akpc806a/Incubator-controller/Firmware/STM32F0308-Discovery/Projects/Demonstration/Binary/readme.txt

/**
  @page Demo_Binary   Description of the STM32F0308-Discovery Demonstration firmware's binary files
  
  @verbatim
  ******************** (C) COPYRIGHT 2013 STMicroelectronics *******************
  * @file    readme.txt 
  * @author  MCD Application Team
  * @version V1.0.0
  * @date    02-October-2013
  * @brief   Description of the STM32F0308-Discovery Demonstration firmware's binary files.
  ******************************************************************************
  *
  * Licensed under MCD-ST Liberty SW License Agreement V2, (the "License");
  * You may not use this file except in compliance with the License.
  * You may obtain a copy of the License at:
  *
  *        http://www.st.com/software_license_agreement_liberty_v2
  *
  * Unless required by applicable law or agreed to in writing, software 
  * distributed under the License is distributed on an "AS IS" BASIS, 
  * WITHOUT WARRANTIES OR CONDITIONS OF ANY KIND, either express or implied.
  * See the License for the specific language governing permissions and
  * limitations under the License.
  *
  ******************************************************************************
   @endverbatim

@par Description

This directory contains binary files (*.hex) of the STM32F0308-Discovery 
Demonstration firmware. 
You can use the STM32F0xx’s embedded Bootloader or any in-system programming tool
to reprogram the demonstration using these binary files, as described below:

 + Using "in-system programming tool"
    - Connect the STM32F0308-Discovery board to a PC with a 'USB type A to Mini-B'
      cable through USB connector CN1 to power the board.
    - Make sure that the embedded ST-LINK/V2 is configured for in-system programming
      (both CN3 jumpers ON)
    - Use "STM32F0308-Discovery_Demonstration_V1.0.0.hex" binary with your preferred 
      in-system programming tool to reprogram the demonstration firmware 
      (ex. STM32 ST-LINK Utility, available for download from www.st.com).
          
 * <h3><center>&copy; COPYRIGHT STMicroelectronics</center></h3>
 */
