akpc806a/Incubator-controller/Hardware/IncubatorControl_BOM.xlsx

Qty | Value | Device | Package | Parts | Description | DigiKey partnum / URL | Price, $ | Extended price
4 | Tactile Switch [6 mm outline] | 10-XX | B3F-10XX | S1, S2, S3, S4 |  | 450-1650-ND | 0.11 | 0.44
1 | 0.01 uF | C-EUC0805 | C0805 | C12 | CAPACITOR, European symbol | 399-1158-2-ND |  | 0
2 | 0.1 uF | C-EUC0805 | C0805 | C3, C11 | CAPACITOR, European symbol | 399-1168-2-ND |  | 0
2 | 1 k | R-EU_R0805 | R0805 | R1, R2 | RESISTOR, European symbol | 311-1.0KARTR-ND |  | 0
5 | 1 uF x 25V | C-EUC0805 | C0805 | C4, C5, C6, C7, C10 | CAPACITOR, European symbol | 311-1358-2-ND |  | 0
2 | 10 uF x 25V | CPOL-EUTT2D4L | TT2D4L | C8, C9 | POLARIZED CAPACITOR, European symbol | P1176-ND | 0.015 | 0.03
1 | 100 | R-EU_R0805 | R0805 | R4 | RESISTOR, European symbol | P100ATR-ND |  | 0
2 | 27 p | C-EUC0805 | C0805 | C1, C2 | CAPACITOR, European symbol | 709-1173-2-ND |  | 0
1 | 3 k | R-EU_R0805 | R0805 | R3 | RESISTOR, European symbol | RMCF0805JT3K00TR-ND |  | 0
2 | 3.3 k | R-EU_R0805 | R0805 | R10, R11 | RESISTOR, European symbol | 1276-5541-2-ND |  | 0
2 | 4.7 k | R-EU_R0805 | R0805 | R8, R9 | RESISTOR, European symbol | P4.7KATR-ND |  | 0
1 | 47 | R-EU_R0805 | R0805 | R5 | RESISTOR, European symbol | RMCF0805JT47R0TR-ND |  | 0
1 | 7805DT | 7805DT | TO252 | IC3 | Positive VOLTAGE REGULATOR | KA7805ERTMFSCT-ND | 0.319 | 0.319
1 | 8 MHz | CRYSTALHC49S | HC49/S | Q1 | CRYSTAL | CTX900-ND | 0.296 | 0.296
4 | BAV99 | BAV199 | SOT23 | D1, D2, D3, D4 | DIODE | BAV99LT1GOSCT-ND | 0.088 | 0.352
1 | BC817-16LT1SMD | BC817-16LT1SMD | SOT23-BEC | Q2 | NPN Transistor | BC817-40LT1GOSCT-ND |  | 0
1 | Passive buzzer [7.6mm pitch] | F/HMB | F/HMB | SG1 | BUZZER Source: Buerklin | http://www.newark.com/multicomp/mckpt-g1410a1-3919/piezo-buzzer/dp/25R0823?ost=MCKPT-G1410A1-3919 | 0.528 | 0.528
1 | ERM802SA-1 | LCD-16X28X2 | LCD-8X2 | U1 | Standard text-only 8x2 parallel input LCD | http://www.buydisplay.com/default/character-display-lcd-8x2-arduino-module-hd44780-array-led-backlight | 3 | 3
1 | LD117AS33TR | LD117AS33TR | SOT223 | IC2 | Low drop fixed and adjustable positive voltage regulators 1 A | NCP1117LPST33T3GOSCT-ND | 0.286 | 0.286
1 | STM32F030F4 | STM32F030F4 | TSSOP20 | IC1 | STM32F030F4 | 497-14044-5-ND | 1.051 | 1.051
 |  |  |  |  |  |  |  | 6.302 | 315.1
 | PCB |  |  |  |  |  |  | 2 | 100
 |  |  |  |  | Total PCB count | 50
