akpc806a/Incubator-controller/Hardware/IncubPower.brd

## EAGLE design Hardware/IncubPower.brd (2014-11-02)

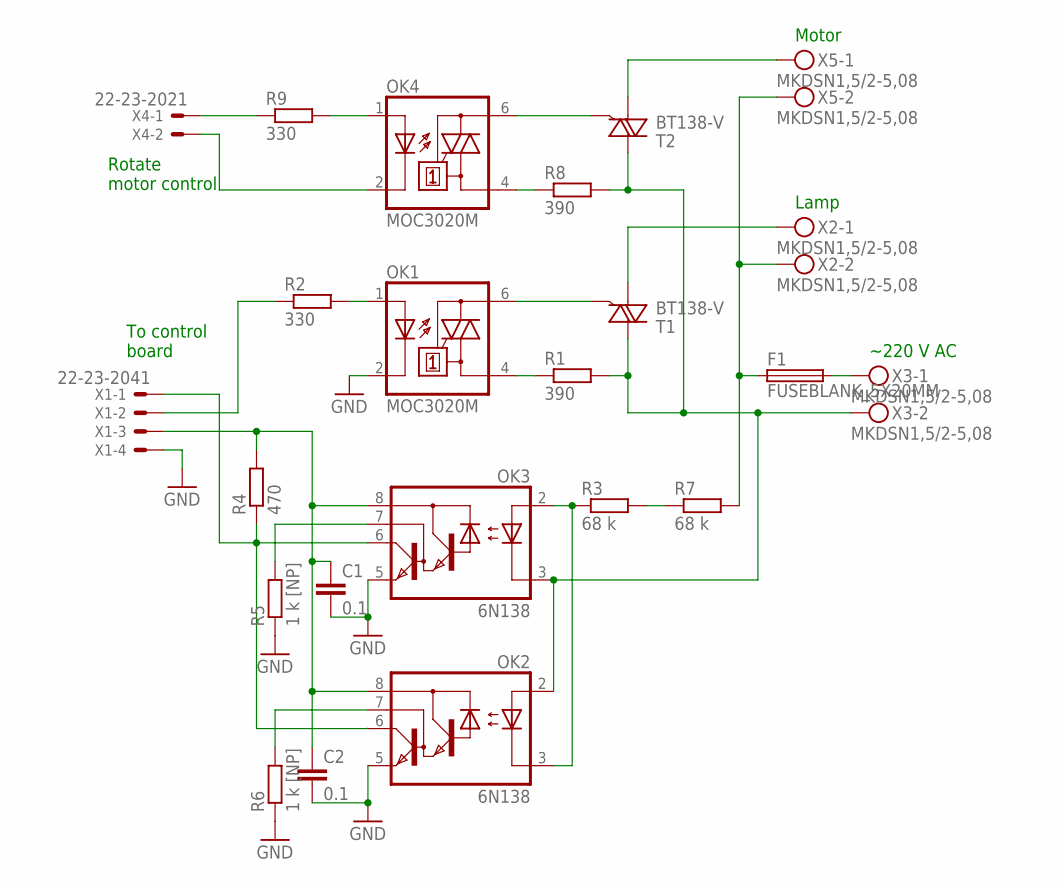
[picture p1: schematic IncubPower.sch]

Parts:
C1, C2: 0.1; C0805
F1: FUSEBLANK_5X20MM; FUSE_HOLDER_5X20MM
OK1, OK4: MOC3020M; DIL06
OK2, OK3: 6N138; DIL08
R1, R8: 390; 0204/7
R2, R9: 330; R0805
R3, R7: 68 k; 0204/7
R4: 470; R0805
R5, R6: 1 k [NP]; R0805
T1, T2: BT138-V; TO220BV
X1: 22-23-2041
X2, X3, X5: MKDSN1,5/2-5,08
X4: 22-23-2021

Connections:
GND: C1.2, C2.2, OK1.2 (C), OK2.5 (GND), OK3.5 (GND), R5.1, R6.1, X1.4
unnamed: OK1.6 (A2), T1.G
unnamed: OK1.4 (A1), R1.1
unnamed: T1.T1 (A1), X2.1
unnamed: OK1.1 (A), R2.2
unnamed: R2.1, X1.2
unnamed: C1.1, C2.1, OK2.8 (VCC), OK3.8 (VCC), R4.2, X1.3
unnamed: F1.1, R7.2, X2.2, X5.2
unnamed: OK2.2 (A), OK3.3 (C), R1.2, R8.2, T1.T2 (A2), T2.T2 (A2), X3.2
unnamed: F1.2, X3.1
unnamed: OK2.3 (C), OK3.2 (A), R3.1
unnamed: OK2.7 (VB), R6.2
unnamed: OK2.6 (VO), OK3.6 (VO), R4.1, X1.1
unnamed: OK3.7 (VB), R5.2
unnamed: R3.2, R7.1
unnamed: OK4.1 (A), R9.2
unnamed: R9.1, X4.1
unnamed: OK4.2 (C), X4.2
unnamed: OK4.6 (A2), T2.G
unnamed: OK4.4 (A1), R8.1
unnamed: T2.T1 (A1), X5.1

Notes on the sheet:
To control board
Lamp
~220 V AC
Rotate motor control
Motor

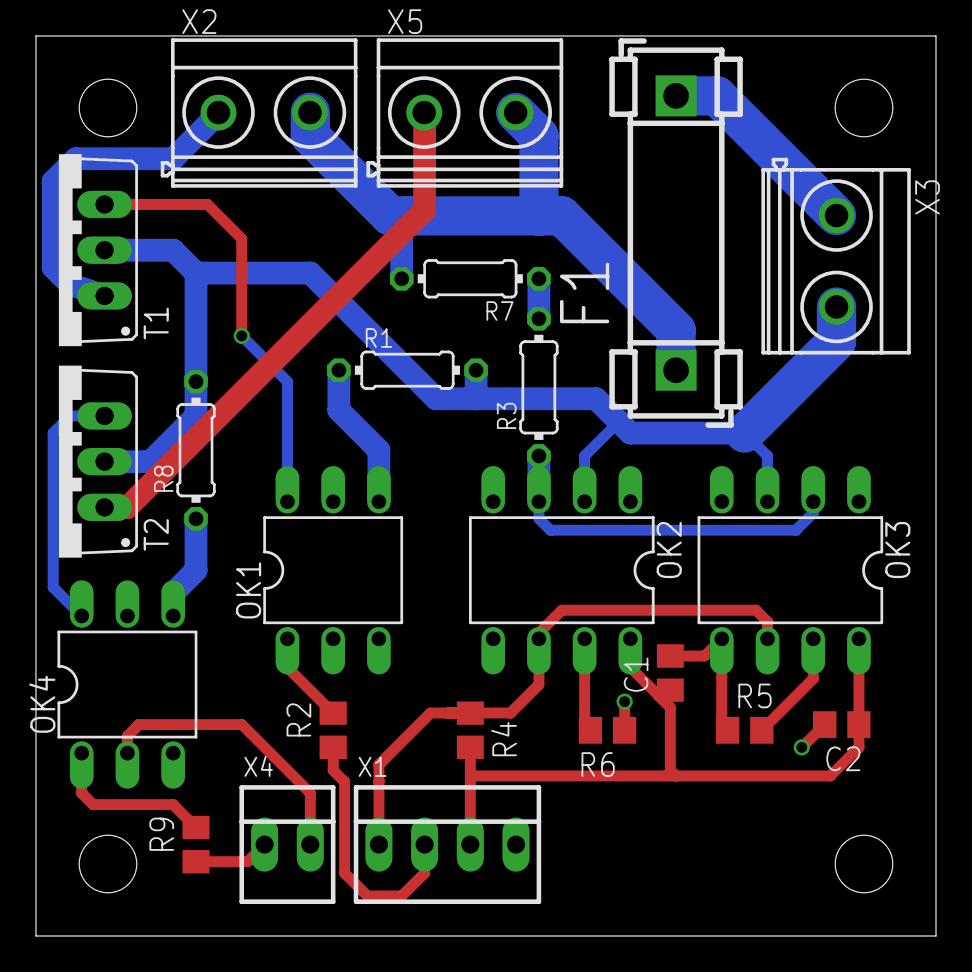
[picture p2: board IncubPower.brd from above]

Board: 2 copper layers, 50.0 x 50.0 mm, 23 parts (0 on the bottom side), 21 nets.
