akpc806a/Incubator-controller/Hardware/Incubator.brd

## EAGLE design Hardware/Incubator.brd (2014-11-02)

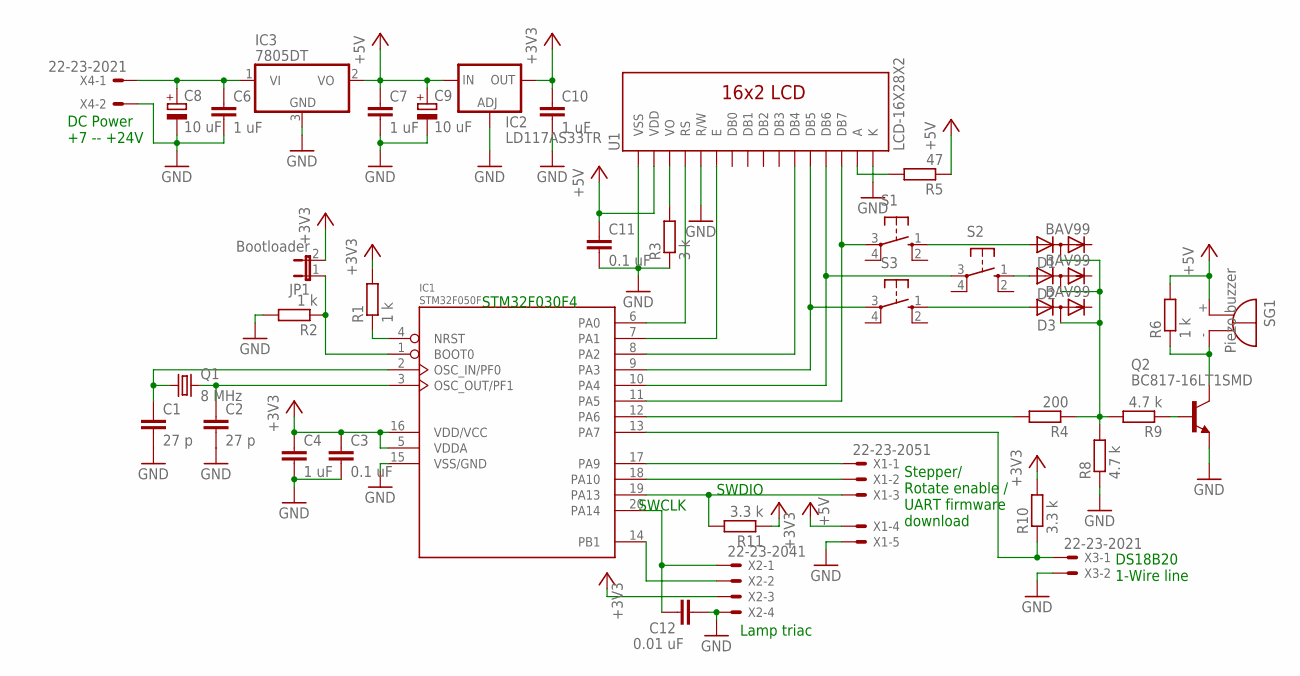
[picture p3: schematic Incubator.sch]

Parts:
C1, C2: 27 p; C0805
C3, C11: 0.1 uF; C0805
C4, C6, C7, C10: 1 uF; C0805
C8, C9: 10 uF; TT2D4L
C12: 0.01 uF; C0805
D1, D2, D3: BAV99; SOT23
IC1: STM32F050F; TSSOP20
IC2: LD117AS33TR; SOT223
IC3: 7805DT; TO252
JP1: Bootloader; JP1
Q1: 8 MHz; HC49/S
Q2: BC817-16LT1SMD; SOT23-BEC
R1, R2, R6: 1 k; R0805
R3: 3 k; R0805
R4: 200; R0805
R5: 47; R0805
R8, R9: 4.7 k; R0805
R10, R11: 3.3 k; R0805
S1, S2, S3: 10-XX; B3F-10XX
SG1: Piezo buzzer; F/HMB
U1: LCD-16X28X2; LCD-8X2
X1: 22-23-2051
X2: 22-23-2041
X3, X4: 22-23-2021

Connections:
+3V3: C3.1, C4.1, C10.1, IC1.5 (VDDA), IC1.16 (VDD/VCC), IC2.4 (OUT), JP1.2, R1.2, R10.2, R11.1, X2.3
+5V: C7.1, C9.+, C11.1, IC2.3 (IN), IC3.2 (VO), R5.1, R6.2, SG1.+, U1.2 (VDD), X1.4
GND: C1.2, C2.2, C3.2, C4.2, C6.2, C7.2, C8.-, C9.-, C10.2, C11.2, C12.2, IC1.15 (VSS/GND), IC2.1 (ADJ), IC3.3 (GND), Q2.E, R2.2, R3.1, R8.1, U1.1 (VSS), U1.5 (R/W), U1.16 (K), X1.5, X2.4, X3.2, X4.2
unnamed: C2.1, IC1.3 (OSC_OUT/PF1), Q1.2
unnamed: C1.1, IC1.2 (OSC_IN/PF0), Q1.1
unnamed: IC1.4 (NRST), R1.1
unnamed: IC1.1 (BOOT0), JP1.1, R2.1
unnamed: IC1.17 (PA9), X1.1
unnamed: IC1.18 (PA10), X1.2
unnamed: IC1.19 (PA13), R11.2, X1.3
unnamed: C12.1, IC1.20 (PA14), X2.1
unnamed: IC1.6 (PA0), U1.4 (RS)
unnamed: IC1.7 (PA1), U1.6 (E)
unnamed: IC1.8 (PA2), U1.11 (DB4)
unnamed: IC1.9 (PA3), S3.3, U1.12 (DB5)
unnamed: IC1.10 (PA4), S2.3, U1.13 (DB6)
unnamed: IC1.11 (PA5), S1.3, U1.14 (DB7)
unnamed: R3.2, U1.3 (VO)
unnamed: D1.3 (AC), D2.3 (AC), D3.3 (AC), R4.1, R8.2, R9.2
unnamed: D1.1 (A), S1.1 (S)
unnamed: D2.1 (A), S2.1 (S)
unnamed: D3.1 (A), S3.1 (S)
unnamed: Q2.B, R9.1
unnamed: Q2.C, R6.1, SG1.-
unnamed: IC1.14 (PB1), X2.2
unnamed: IC1.12 (PA6), R4.2
unnamed: IC1.13 (PA7), R10.1, X3.1
unnamed: C6.1, C8.+, IC3.1 (VI), X4.1
unnamed: R5.2, U1.15 (A)

Notes on the sheet:
Stepper/ Rotate enable / UART firmware download
DS18B20 1-Wire line
Lamp triac
DC Power +7 -- +24V
SWDIO
SWCLK
STM32F030F4

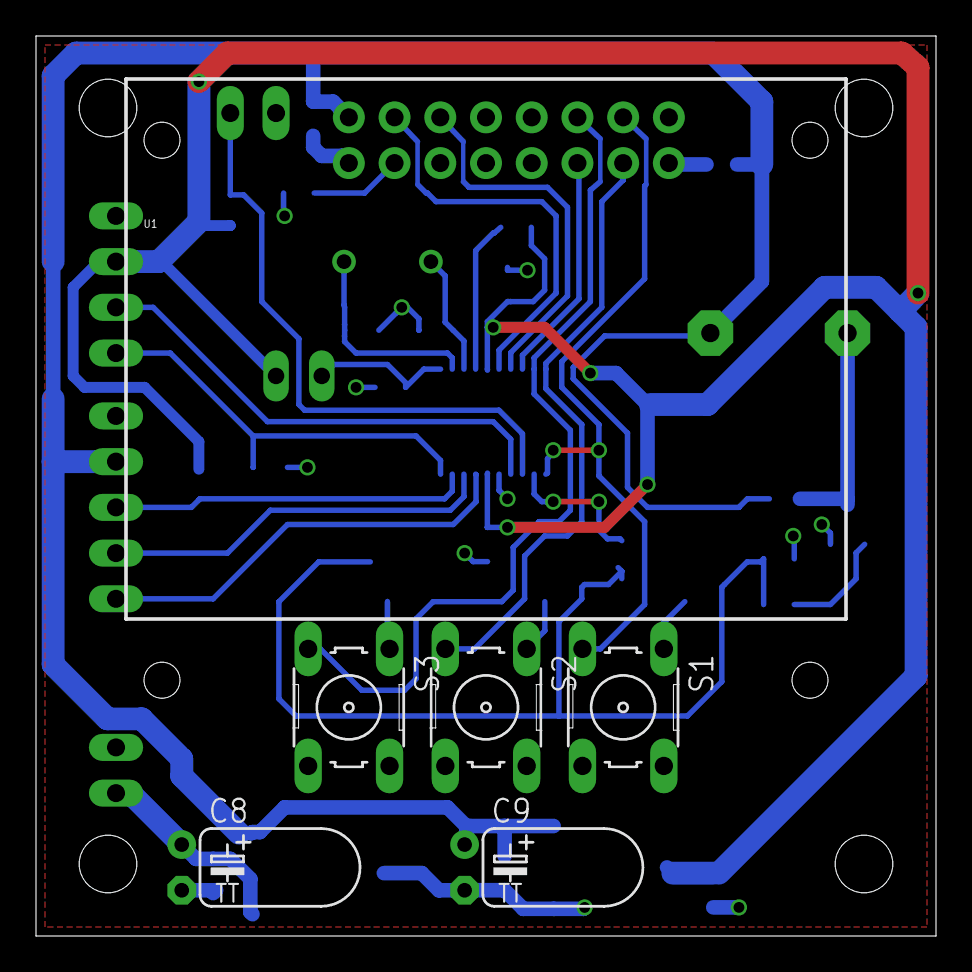
[picture p4: board Incubator.brd from above]

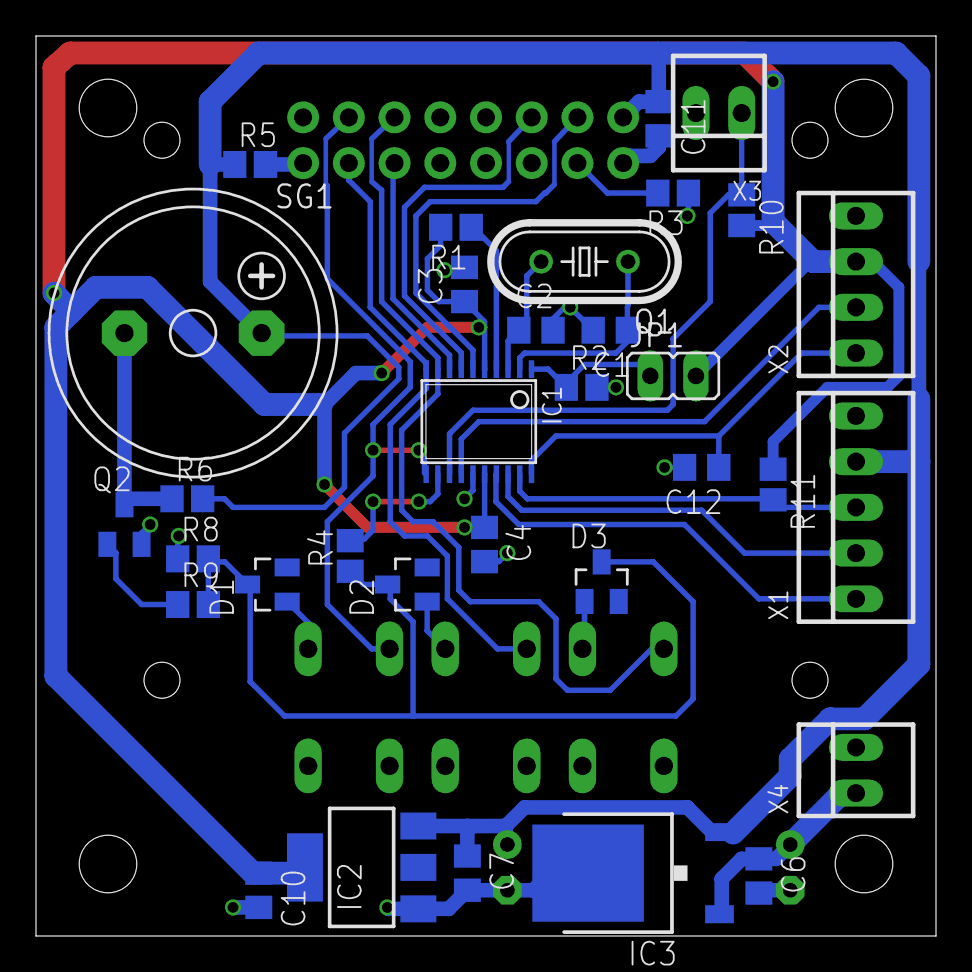
[picture p5: board Incubator.brd from below]

Board: 2 copper layers, 50.0 x 50.0 mm, 39 parts (33 on the bottom side), 29 nets.
