akpc806a/Incubator-controller/(commit log)

2014-09-14 Initial version
    - Hardware: ordered at DirtyPCBs
    - Firmware: tested at STM32F0308-Discovery board
    [IncubPower.brd, IncubPower.sch, Incubator.brd, Incubator.sch, IncubatorControl_BOM.xlsx]
2014-11-02 Release version
    Version for production
    - 3 buttons on control board
    [IncubPower.brd, IncubPower.sch, Incubator.brd, Incubator.sch]
